dagueroc/Proyecto-El-ctrico/README.md

Universidad de Costa Rica
Escuela de Ingeniería Eléctrica
IE-0499 Proyecto Eléctrico

Dylan Agüero
