dagueroc/Proyecto-El-ctrico/Diseños/Soporte Rejilla.stl

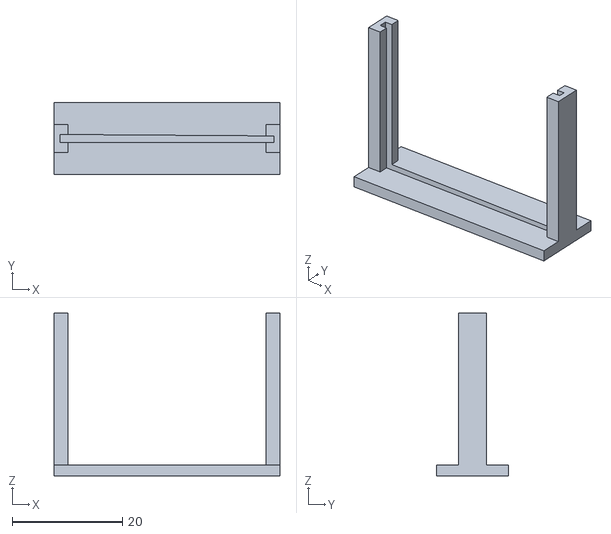
[picture p1: CAD file, 2024-12-01]
Diseños/Soporte Rejilla.stl
41.0 x 13.0 x 29.5
