dagueroc/Proyecto-El-ctrico/Diseños/Soporte Móvil.stl

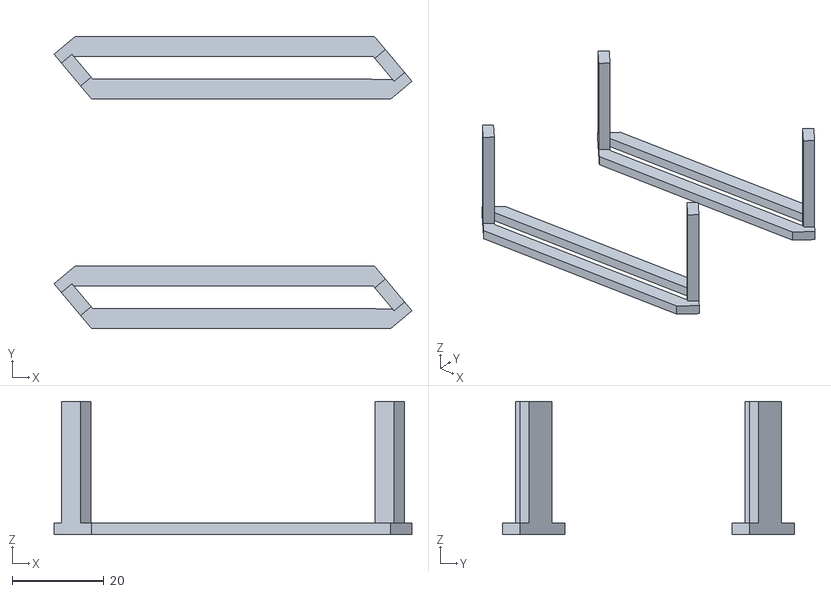
[picture p2: CAD file, 2024-12-01]
Diseños/Soporte Móvil.stl
78.0 x 63.7 x 29.0
