dagueroc/Proyecto-El-ctrico/Diseños/Tapa.stl

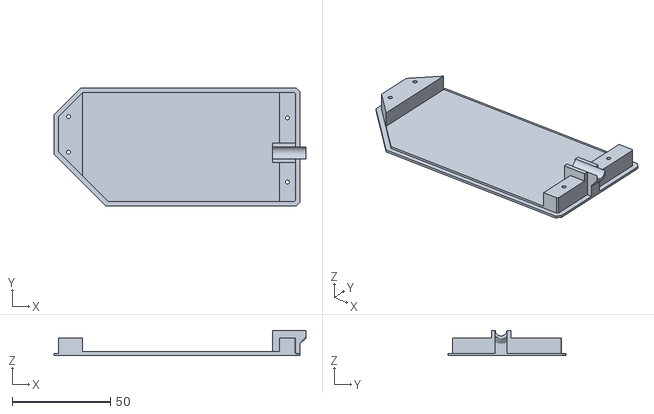
[picture p3: CAD file, 2024-12-01]
Diseños/Tapa.stl
128.0 x 60.0 x 12.8
