dagueroc/Proyecto-El-ctrico/Diseños/Diseño con todas las partes.stl

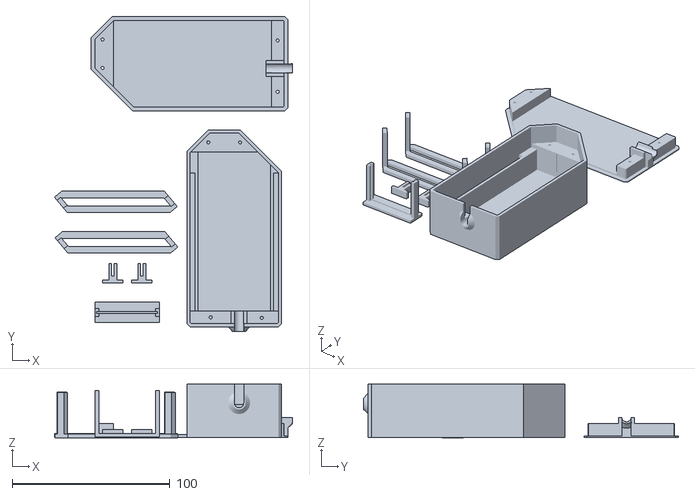
[picture p4: CAD file, 2024-12-01]
Diseños/Diseño con todas las partes.stl
151.2 x 200.0 x 34.2
