dagueroc/Proyecto-El-ctrico/Diseños/Base.stl

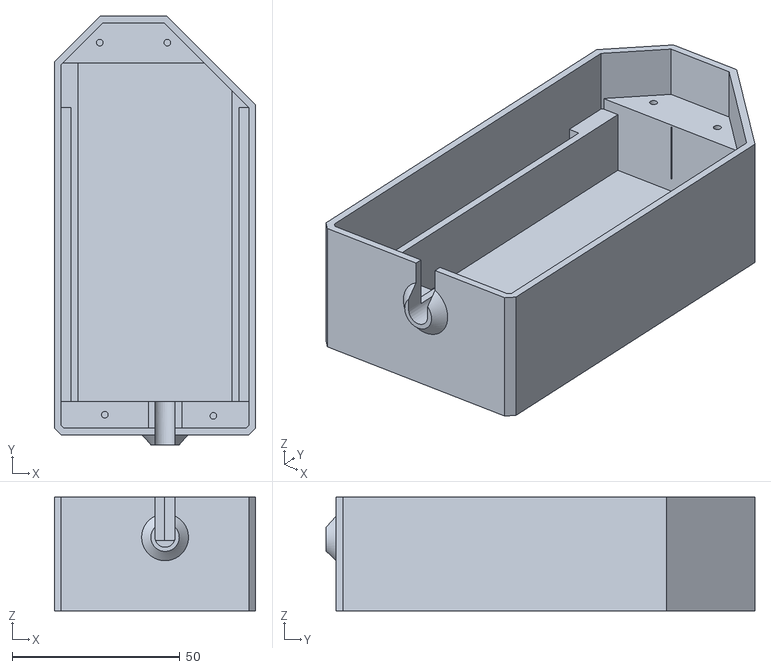
[picture p5: CAD file, 2024-12-01]
Diseños/Base.stl
60.0 x 128.0 x 34.0
