dagueroc/Proyecto-El-ctrico/Diseños/Soporte Cámara.stl

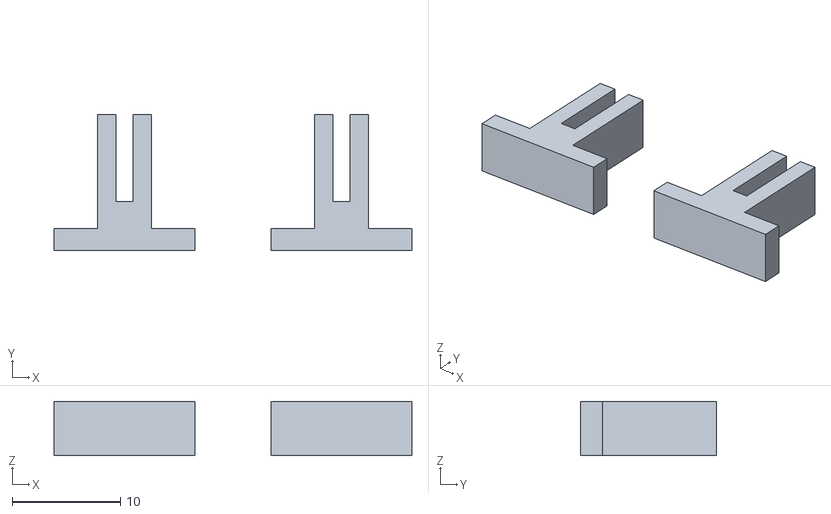
[picture p6: CAD file, 2024-12-01]
Diseños/Soporte Cámara.stl
33.0 x 12.5 x 5.00
